MAMMARU-class/Arachne/control_board/control_board.kicad_pcb

## KiCad design control_board/control_board.kicad_pcb (2024-09-03)

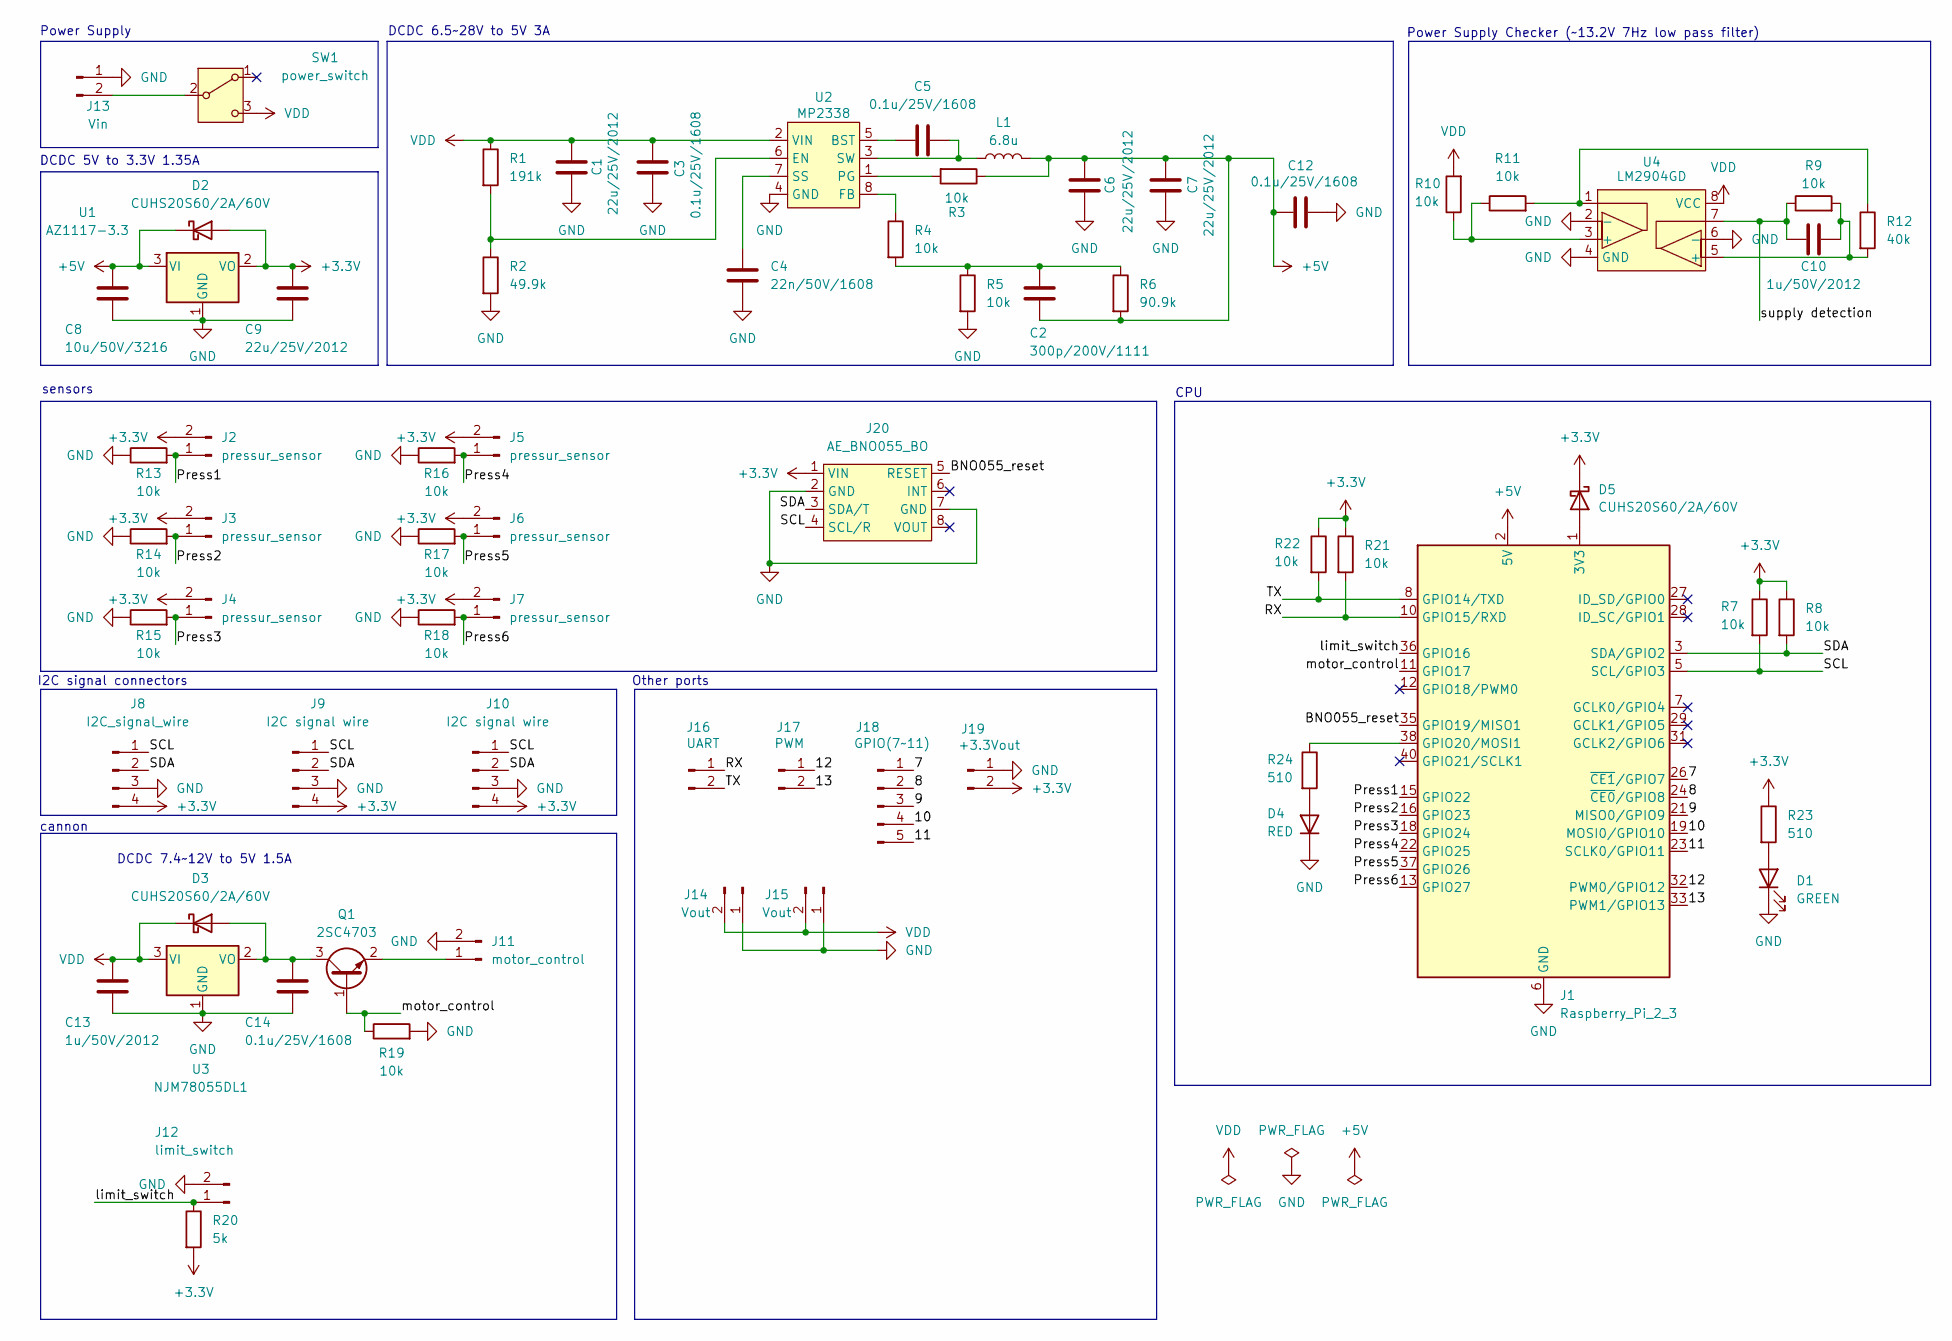
[picture p1: schematic control_board.kicad_sch]

Parts:
C1, C6, C7, C9: 22u/25V/2012; C_0805_2012Metric
C2: 300p/200V/1111; Capacitor_SMD_2.7x2.7
C3, C5, C12, C14: 0.1u/25V/1608; C_0603_1608Metric
C4: 22n/50V/1608; C_0603_1608Metric
C8: 10u/50V/3216; C_1206_3216Metric
C10, C13: 1u/50V/2012; C_0805_2012Metric
D1: GREEN; LED_0603_1608Metric
D2, D3, D5: CUHS20S60/2A/60V; D_SOD-323
D4: RED; LED_0603_1608Metric
J1: Raspberry_Pi_2_3; Raspberry_Pi_Zero_Socketed_THT_FaceDown_MountingHoles_with_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
J2, J3, J4, J5, J6, J7: pressur_sensor; JST_XH_S2B-XH-A_1x02_P2.50mm_Horizontal
J8: I2C_signal_wire; JST_XH_S4B-XH-A_1x04_P2.50mm_Horizontal
J9: I2C signal wire; JST_XH_S4B-XH-A_1x04_P2.50mm_Horizontal
J10: I2C signal wire; JST_XH_B4B-XH-A_1x04_P2.50mm_Vertical
J11: motor_control; JST_XH_S2B-XH-A_1x02_P2.50mm_Horizontal
J12: limit_switch; JST_XH_S2B-XH-A_1x02_P2.50mm_Horizontal
J13: Vin; JST_VH_B2PS-VH_1x02_P3.96mm_Horizontal
J14, J15: Vout; JST_VH_B2PS-VH_1x02_P3.96mm_Horizontal
J16: UART; JST_XH_B2B-XH-A_1x02_P2.50mm_Vertical
J17: PWM; PinHeader_1x02_P2.54mm_Vertical
J18: GPIO(7~11); PinHeader_1x05_P2.54mm_Vertical
J19: +3.3Vout; JST_XH_B2B-XH-A_1x02_P2.50mm_Vertical
J20: AE_BNO055_BO; DIP-8_W7.62mm_Socket
L1: 6.8u; L_NLV32-PF_SMD_3.2x2.5_handsolder
Q1: 2SC4703; SOT-89-3_Handsoldering
R1: 191k; R_0603_1608Metric_Pad0.98x0.95mm_HandSolder
R2: 49.9k; R_0603_1608Metric_Pad0.98x0.95mm_HandSolder
R3, R4, R5, R7, R8, R9, R10, R11, R13, R14, R15, R16, R17, R18, R19, R21, R22: 10k; R_0603_1608Metric_Pad0.98x0.95mm_HandSolder
R6: 90.9k; R_0603_1608Metric_Pad0.98x0.95mm_HandSolder
R12: 40k; R_0603_1608Metric_Pad0.98x0.95mm_HandSolder
R20: 5k; R_0603_1608Metric_Pad0.98x0.95mm_HandSolder
R23, R24: 510; R_0603_1608Metric_Pad0.98x0.95mm_HandSolder
SW1: power_switch; Toggle_Switch_2MS1-T1-B4-M2-Q-E
U1: AZ1117-3.3; SOT-223-3_TabPin2
U2: MP2338; SOT-583-8
U3: NJM78055DL1; TO-252-2
U4: LM2904GD; SOP-8_3.76x4.96mm_P1.27mm

Connections:
+3.3V: C9.1, D2.2 (A), D5.1 (K), J2.2, J3.2, J4.2, J5.2, J6.2, J7.2, J8.4, J9.4, J10.4, J19.2, J20.1 (VIN), R7.1, R8.1, R20.2, R21.1, R22.1, R23.1, U1.2 (VO)
+5V: C2.2, C6.1, C7.1, C8.1, C12.1, D2.1 (K), J1.2 (5V), J1.4 (5V), L1.2, R3.1, R6.2, U1.3 (VI)
/7: J1.26 (~CE1/GPIO7), J18.1
/8: J1.24 (~CE0/GPIO8), J18.2
/9: J1.21 (MISO0/GPIO9), J18.3
/10: J1.19 (MOSI0/GPIO10), J18.4
/11: J1.23 (SCLK0/GPIO11), J18.5
/12: J1.32 (PWM0/GPIO12), J17.1
/13: J1.33 (PWM1/GPIO13), J17.2
/BNO055_reset: J1.35 (GPIO19/MISO1), J20.5 (RESET)
/Press1: J1.15 (GPIO22), J2.1, R13.2
/Press2: J1.16 (GPIO23), J3.1, R14.2
/Press3: J1.18 (GPIO24), J4.1, R15.2
/Press4: J1.22 (GPIO25), J5.1, R16.2
/Press5: J1.37 (GPIO26), J6.1, R17.2
/Press6: J1.13 (GPIO27), J7.1, R18.2
/RX: J1.10 (GPIO15/RXD), J16.1, R21.2
/SCL: J1.5 (SCL/GPIO3), J8.1, J9.1, J10.1, J20.4 (SCL/R), R7.2
/SDA: J1.3 (SDA/GPIO2), J8.2, J9.2, J10.2, J20.3 (SDA/T), R8.2
/TX: J1.8 (GPIO14/TXD), J16.2, R22.2
/limit_switch: J1.36 (GPIO16), J12.1, R20.1
/motor_control: J1.11 (GPIO17), Q1.1 (B), R19.1
/supply detection: C10.1, R9.1, U4.7
GND: C1.2, C3.2, C4.2, C6.2, C7.2, C8.2, C9.2, C12.2, C13.2, C14.2, D1.1 (K), D4.1 (K), J1.6 (GND), J1.9 (GND), J1.14 (GND), J1.20 (GND), J1.25 (GND), J1.30 (GND), J1.34 (GND), J1.39 (GND), J8.3, J9.3, J10.3, J11.2, J12.2, J13.1, J14.1, J15.1, J19.1, J20.2 (GND), J20.7 (GND), R2.2, R5.2, R13.1, R14.1, R15.1, R16.1, R17.1, R18.1, R19.2, U1.1 (GND), U2.4 (GND), U3.1 (GND), U4.2 (-), U4.4 (GND), U4.6 (-)
unnamed: C2.1, R4.2, R5.1, R6.1
unnamed: C10.2, R9.2, R12.2, U4.5 (+)
unnamed: D1.2 (A), R23.2
unnamed: C14.1, D3.2 (A), Q1.3 (C), U3.2 (VO)
unnamed: D4.2 (A), R24.2
unnamed: D5.2 (A), J1.1 (3V3), J1.17 (3V3)
unnamed: J1.38 (GPIO20/MOSI1), R24.1
unnamed: J11.1, Q1.2 (E)
unnamed: J13.2, SW1.2 (B)
unnamed: R10.1, R11.1, U4.3 (+)
unnamed: R11.2, R12.1, U4.1
unnamed: C5.2, U2.5 (BST)
unnamed: R1.2, R2.1, U2.6 (EN)
unnamed: R4.1, U2.8 (FB)
unnamed: R3.2, U2.1 (PG)
unnamed: C4.1, U2.7 (SS)
unnamed: C5.1, L1.1, U2.3 (SW)
VDD: C1.1, C3.1, C13.1, D3.1 (K), J14.2, J15.2, R1.1, R10.2, SW1.3 (C), U2.2 (VIN), U3.3 (VI), U4.8 (VCC)

Notes on the sheet:
Power Supply
I2C signal connectors
Other ports
DCDC 7.4~12V to 5V 1.5A
CPU
sensors
DCDC 5V to 3.3V 1.35A
cannon
DCDC 6.5~28V to 5V 3A
Power Supply Checker (~13.2V 7Hz low pass filter)

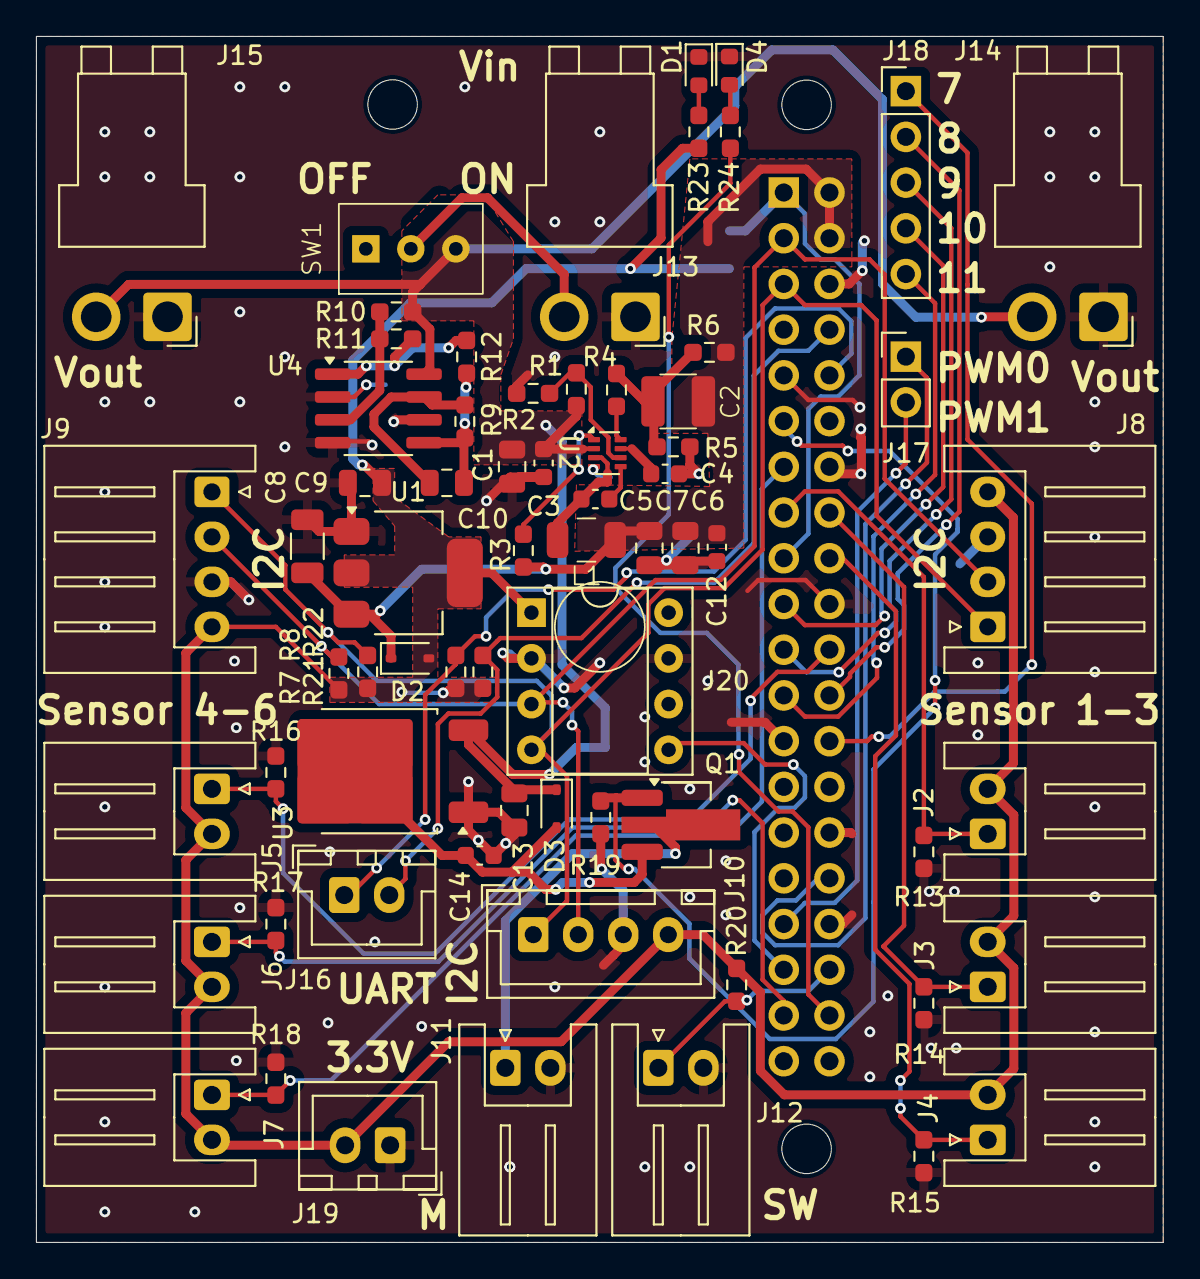
[picture p2: board control_board.kicad_pcb from above]

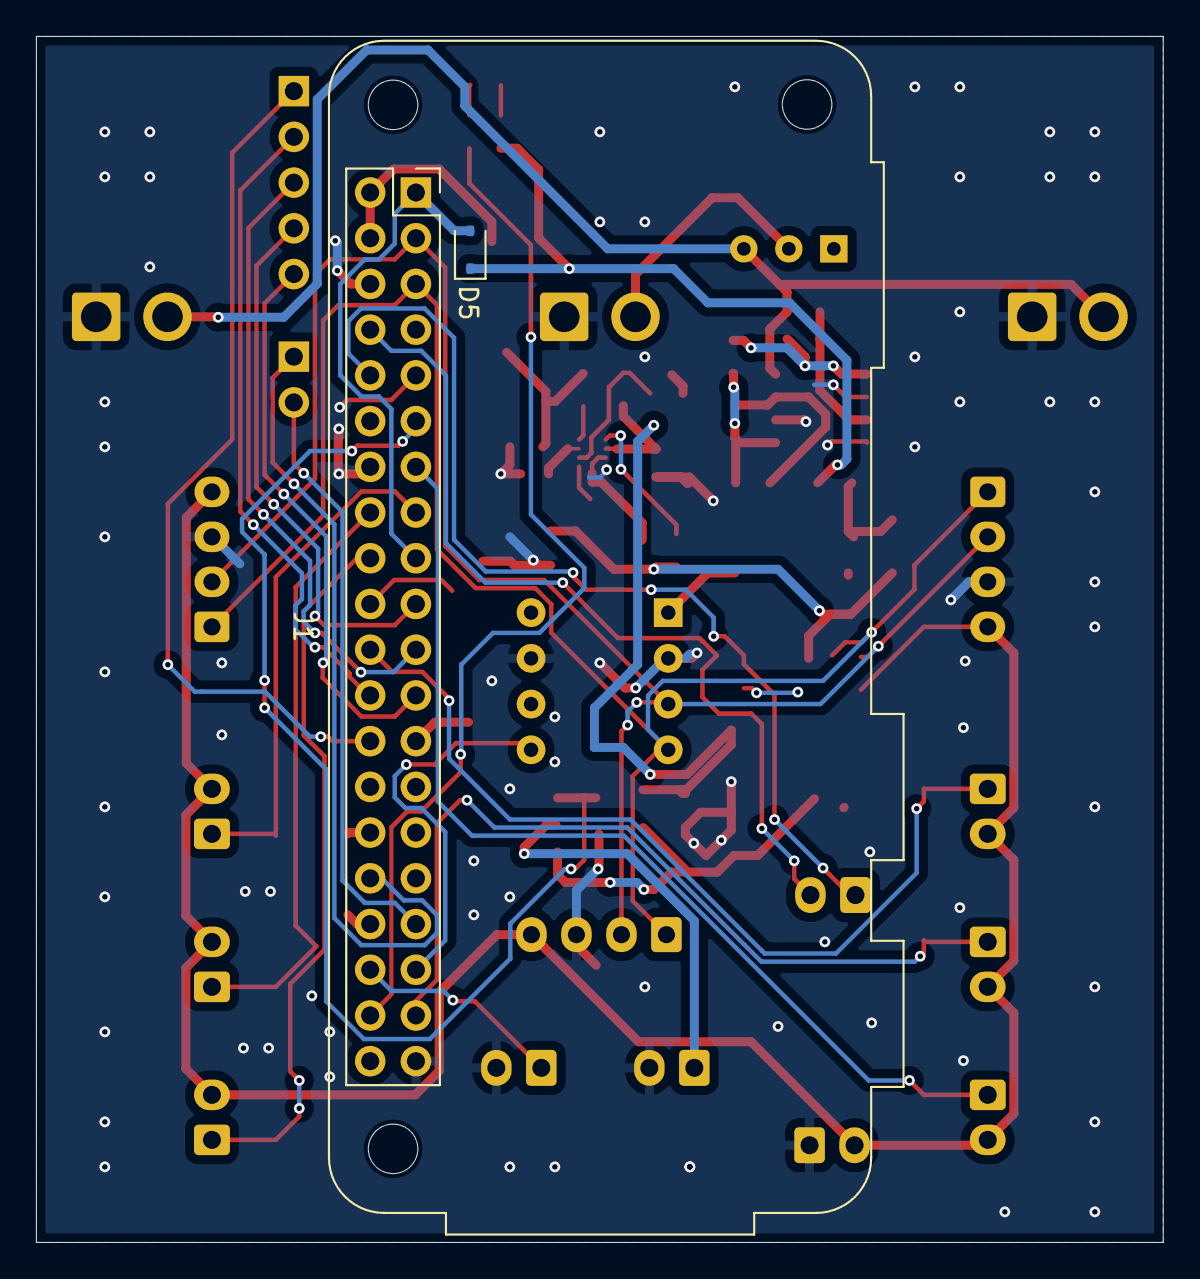
[picture p3: board control_board.kicad_pcb from below]

Board: 2 copper layers, 62.6 x 67.0 mm, 69 parts (2 on the bottom side), 42 nets.
